johnwinans/camera-boom/stl/mountblock.stl

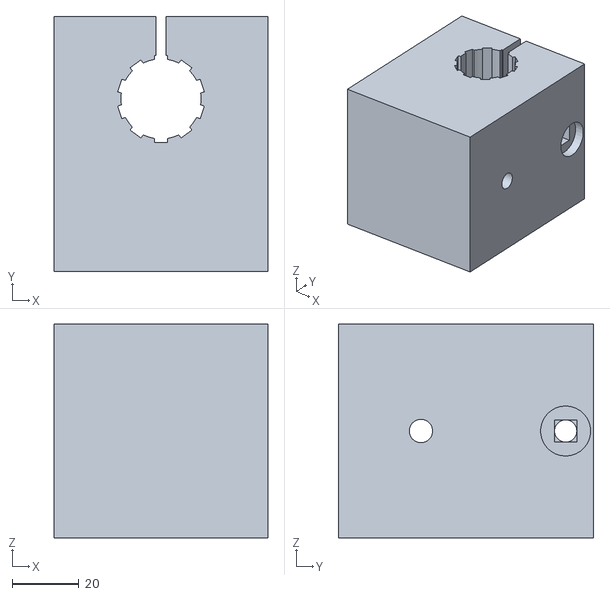
[picture p6: CAD file, 2021-06-24]
stl/mountblock.stl
64.0 x 76.4 x 64.0
