johnwinans/camera-boom/stl/v1block.stl

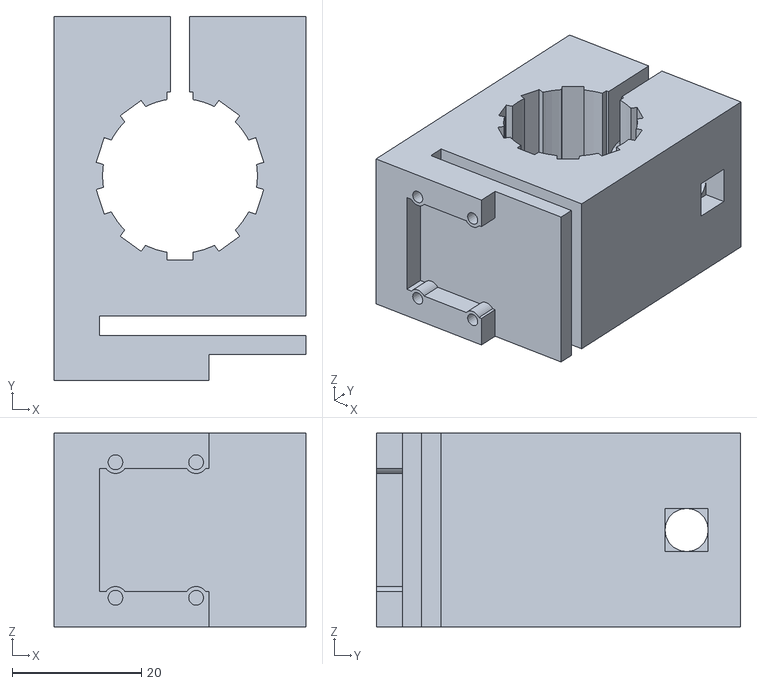
[picture p7: CAD file, 2021-06-16]
stl/v1block.stl
39.0 x 56.4 x 30.0
