johnwinans/camera-boom/stl/hqblock.stl

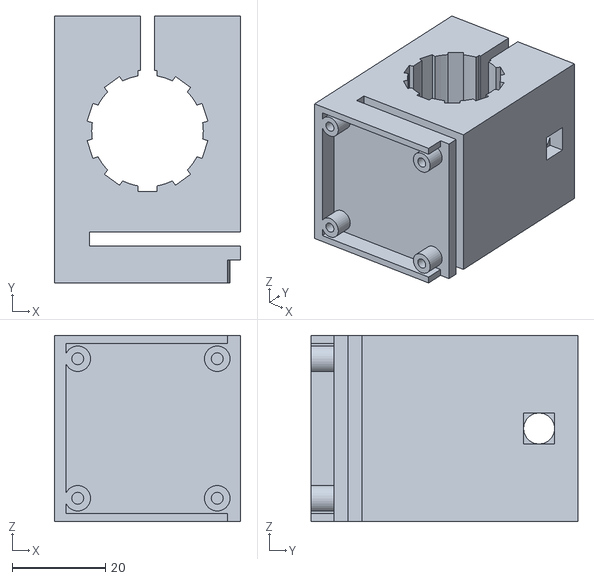
[picture p8: CAD file, 2021-06-16]
stl/hqblock.stl
40.0 x 57.4 x 40.0
