johnwinans/camera-boom/stl/piblock.stl

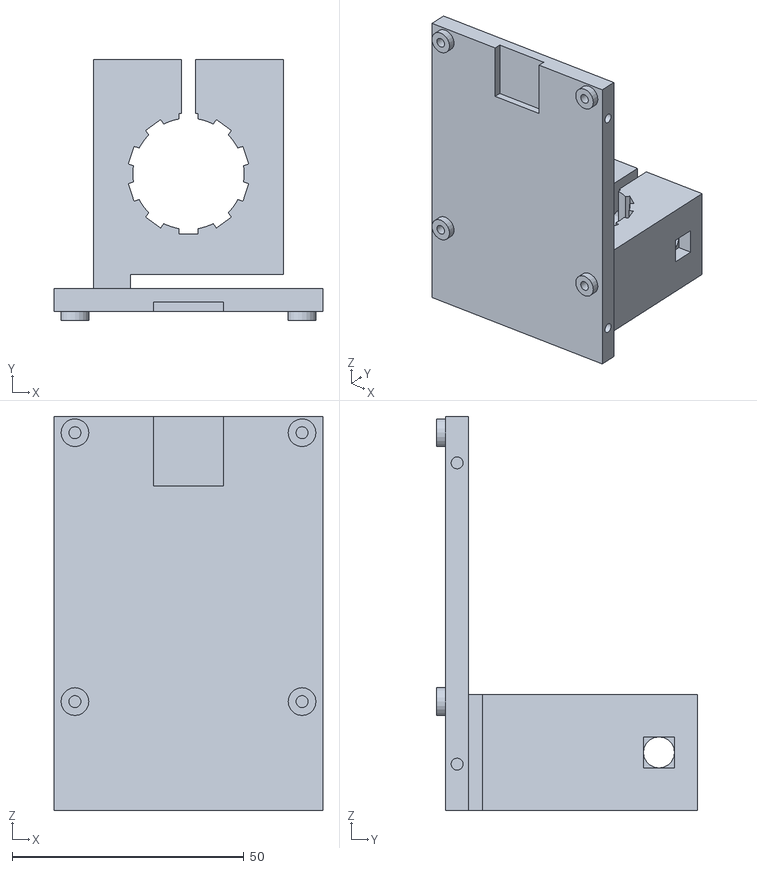
[picture p9: CAD file, 2021-06-16]
stl/piblock.stl
58.0 x 56.4 x 85.0
