johnwinans/camera-boom/stl/crossblock.stl

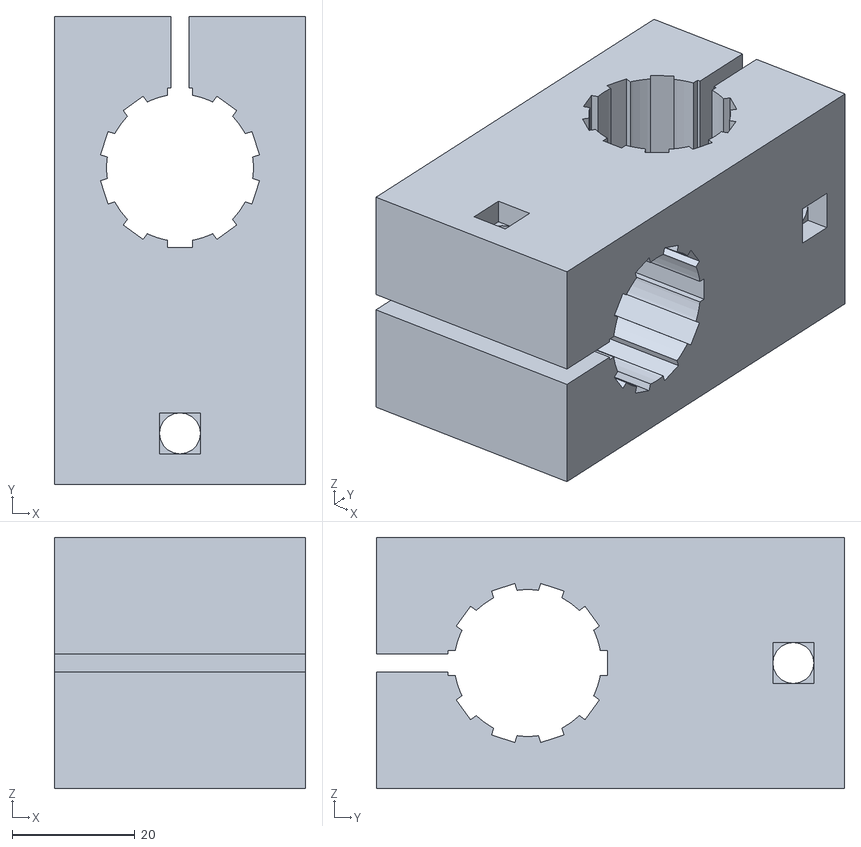
[picture p10: CAD file, 2021-06-16]
stl/crossblock.stl
41.0 x 76.4 x 41.0
