johnwinans/camera-boom/stl/collet.stl

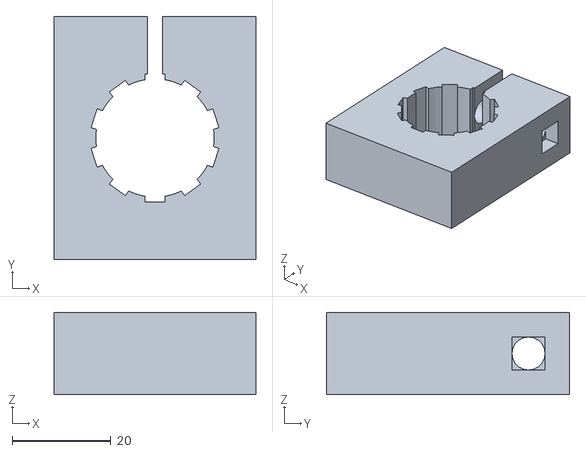
[picture p11: CAD file, 2021-06-16]
stl/collet.stl
41.0 x 49.4 x 16.7
