johnwinans/camera-boom/stl/crossblock-30.stl

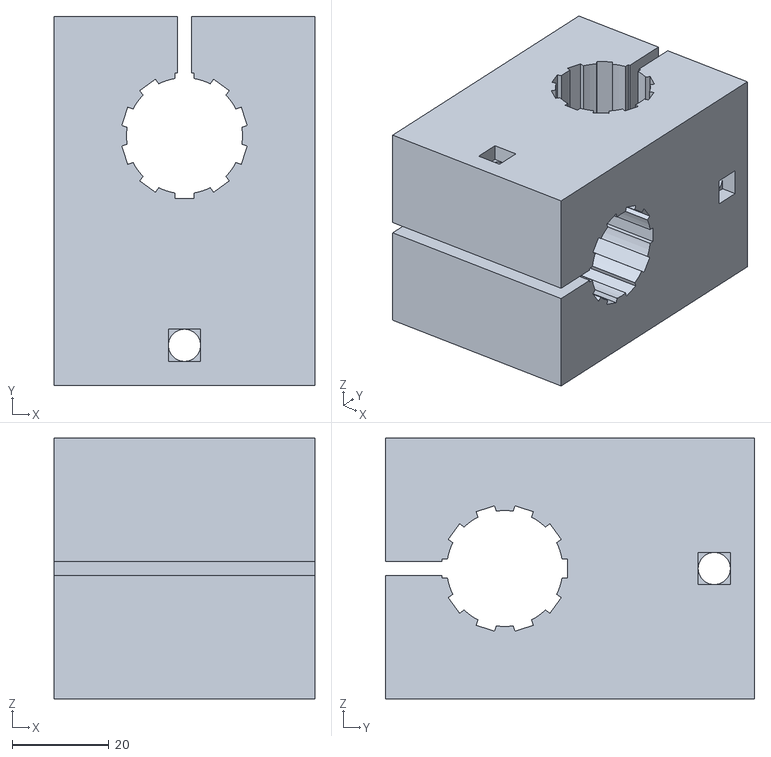
[picture p12: CAD file, 2021-06-11]
stl/crossblock-30.stl
54.0 x 76.4 x 54.0
