johnwinans/camera-boom/(list of files, cad)

Other CAD files:
crossblock.scad
hqblock.scad
mountblock.scad
piblock.scad
qr-clamp.scad
unistrutclamp.scad
v1block.scad
