johnwinans/camera-boom/(commit log)

2021-06-11 First draft.
    [collet.scad, crossblock.scad, hqblock.scad, piblock.scad, v1block.scad]
2021-06-11 Added images & sample STL files.
    [collet.stl, crossblock.stl, hqblock.stl, piblock.stl, v1block.stl]
2021-06-11 Add assembly instructions and a large crossblock file.
    [crossblock-30.stl]
2021-06-11 Reduce M2 bolt tap diameter
2021-06-11 Increase the void around the ribbon connector.
    [v1block.scad]
2021-06-11 Remove material around the mounting holes
    [hqblock.scad]
2021-06-11 Increase clearances around camera mounting holes.
2021-06-11 Re-render the sample STL files
    [collet.stl, crossblock.stl, hqblock.stl, piblock.stl, v1block.stl]
2021-06-16 Code cleanup and rerender STL files.
    [collet.stl, crossblock.stl, hqblock.stl, piblock.scad, piblock.stl, v1block.stl]
2021-06-22 Add parmas for countersinking the clamp bolt head
2021-06-24 Add mountblock.scad (to connect a boom to a horizontal surface with a lag screw)
    [mountblock.scad, mountblock.stl]
2021-06-24 Update README.md
    Added mountblock.scad
2023-12-29 Added a unistrut mounting clamp
    [unistrutclamp.scad]
2023-12-30 Make bolt hole a bit more practical
    [unistrutclamp.scad]
2023-12-30 Add clearance & protect the SD card
    [piblock.scad]
2023-12-30 Add a setscrew option
    [collet.scad]
2024-01-24 Countersink bolt heads & shrink the block
    [crossblock.scad]
2024-01-29 Quick-release clamp for 3/4" conduit
    [qr-clamp.scad]
